notathip/PnET-CT23-Image-Processing-Auto-Alignment-Wireless-Charger/hardware/cad/README.md

# แบบจำลองสามมิติ

ภาพแบบประกอบอยู่ในโฟลเดอร์นี้ ไฟล์ Fusion ของแบบประกอบคือ `wireless_charger_assembly.f3d` เปิดใน Autodesk Fusion ด้วยคำสั่ง File > Open > Open from my computer
