notathip/PnET-CT23-Image-Processing-Auto-Alignment-Wireless-Charger/videos/README.md

# วิดีโอการทำงาน

- คลิปการทำงานของระบบ: https://youtube.com/shorts/St81rVh33vE
