notathip/PnET-CT23-Image-Processing-Auto-Alignment-Wireless-Charger/docs/block_diagram.png

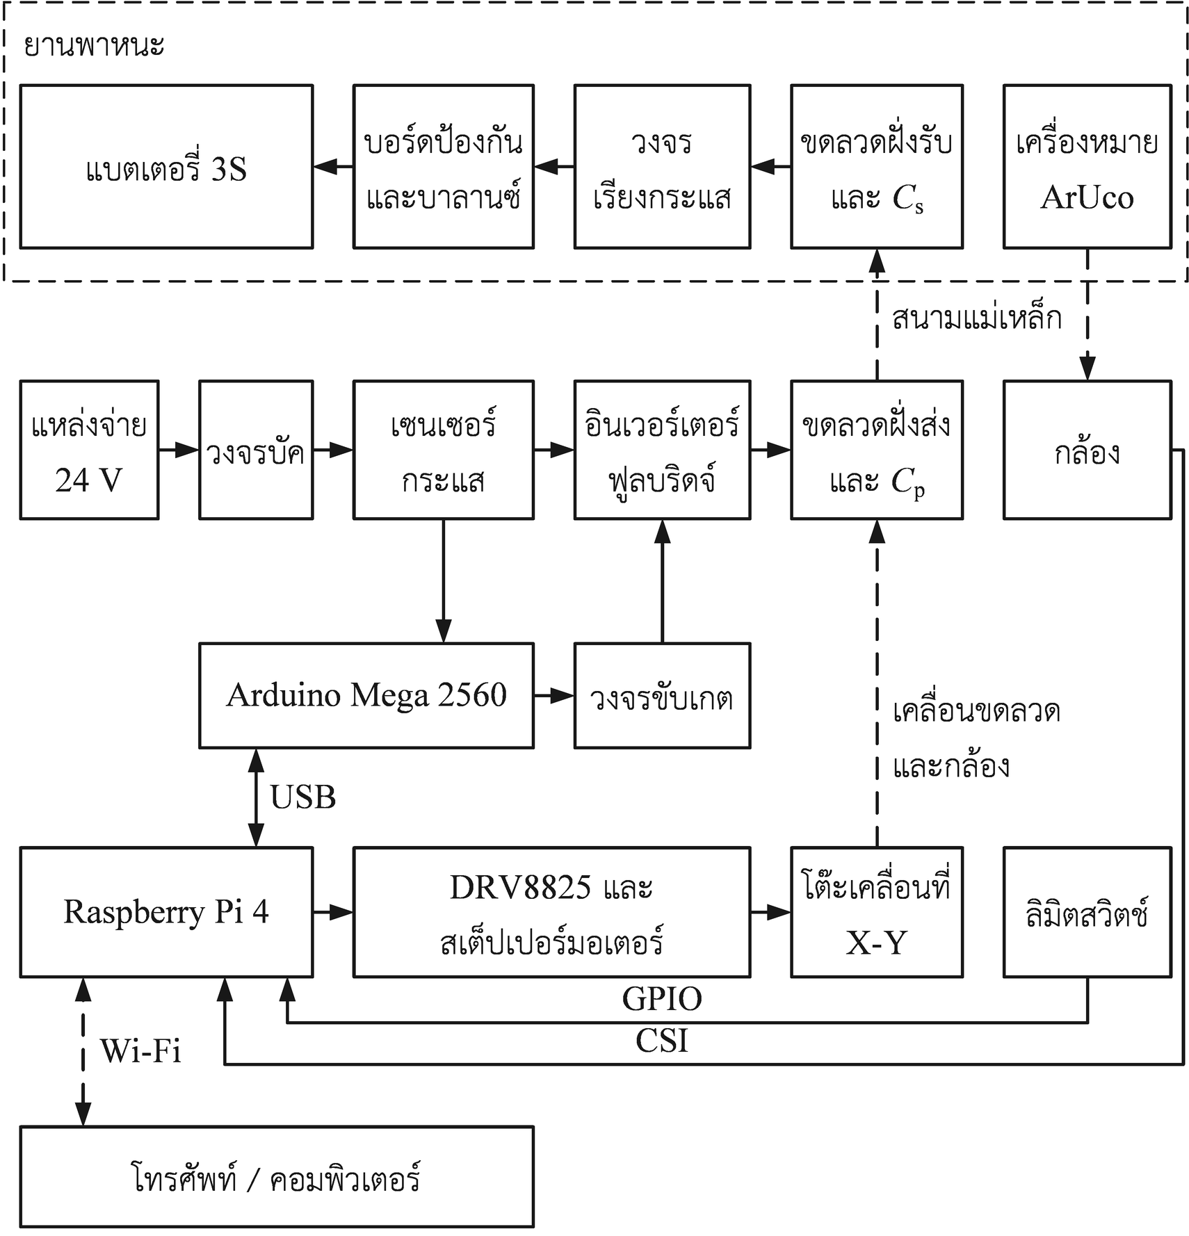
docs/block_diagram.png
