notathip/PnET-CT23-Image-Processing-Auto-Alignment-Wireless-Charger/docs/communication.png

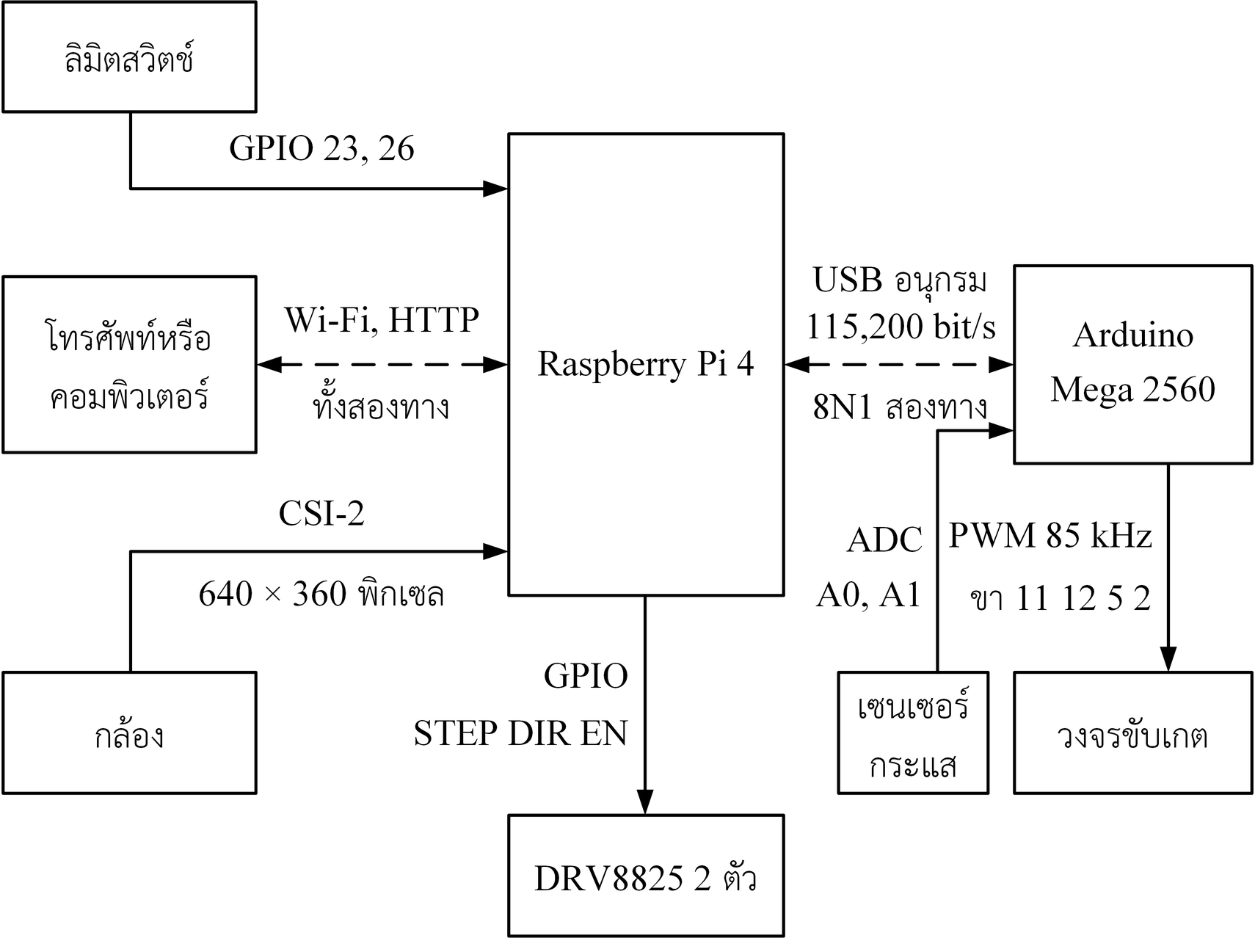
docs/communication.png
