notathip/PnET-CT23-Image-Processing-Auto-Alignment-Wireless-Charger/docs/sequence_power_stop.png

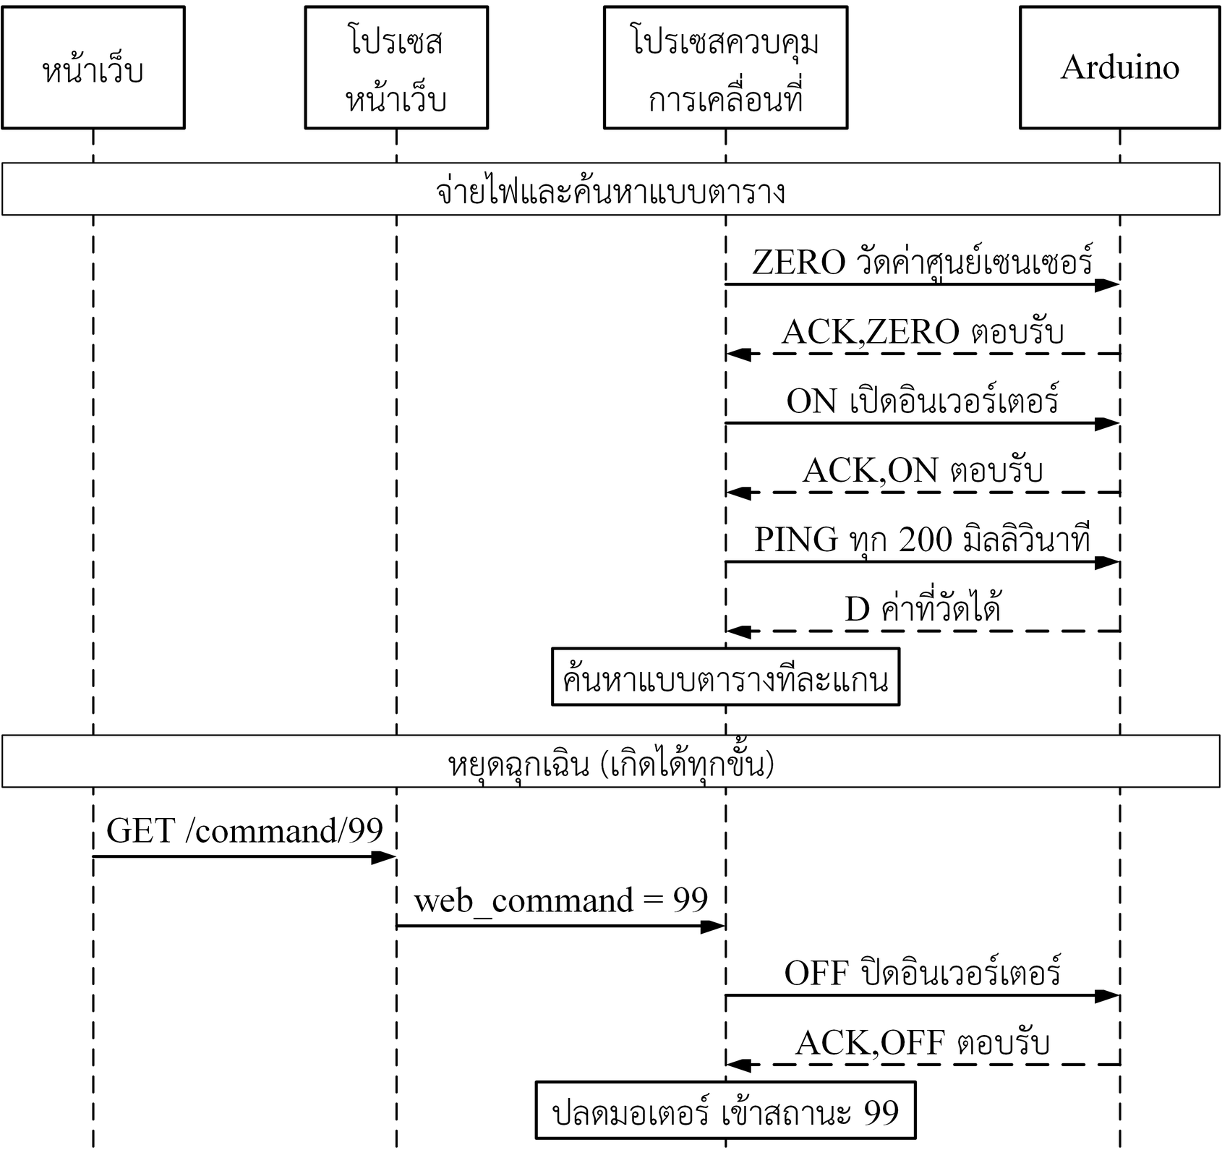
docs/sequence_power_stop.png
