notathip/PnET-CT23-Image-Processing-Auto-Alignment-Wireless-Charger/docs/sequence_search_aim.png

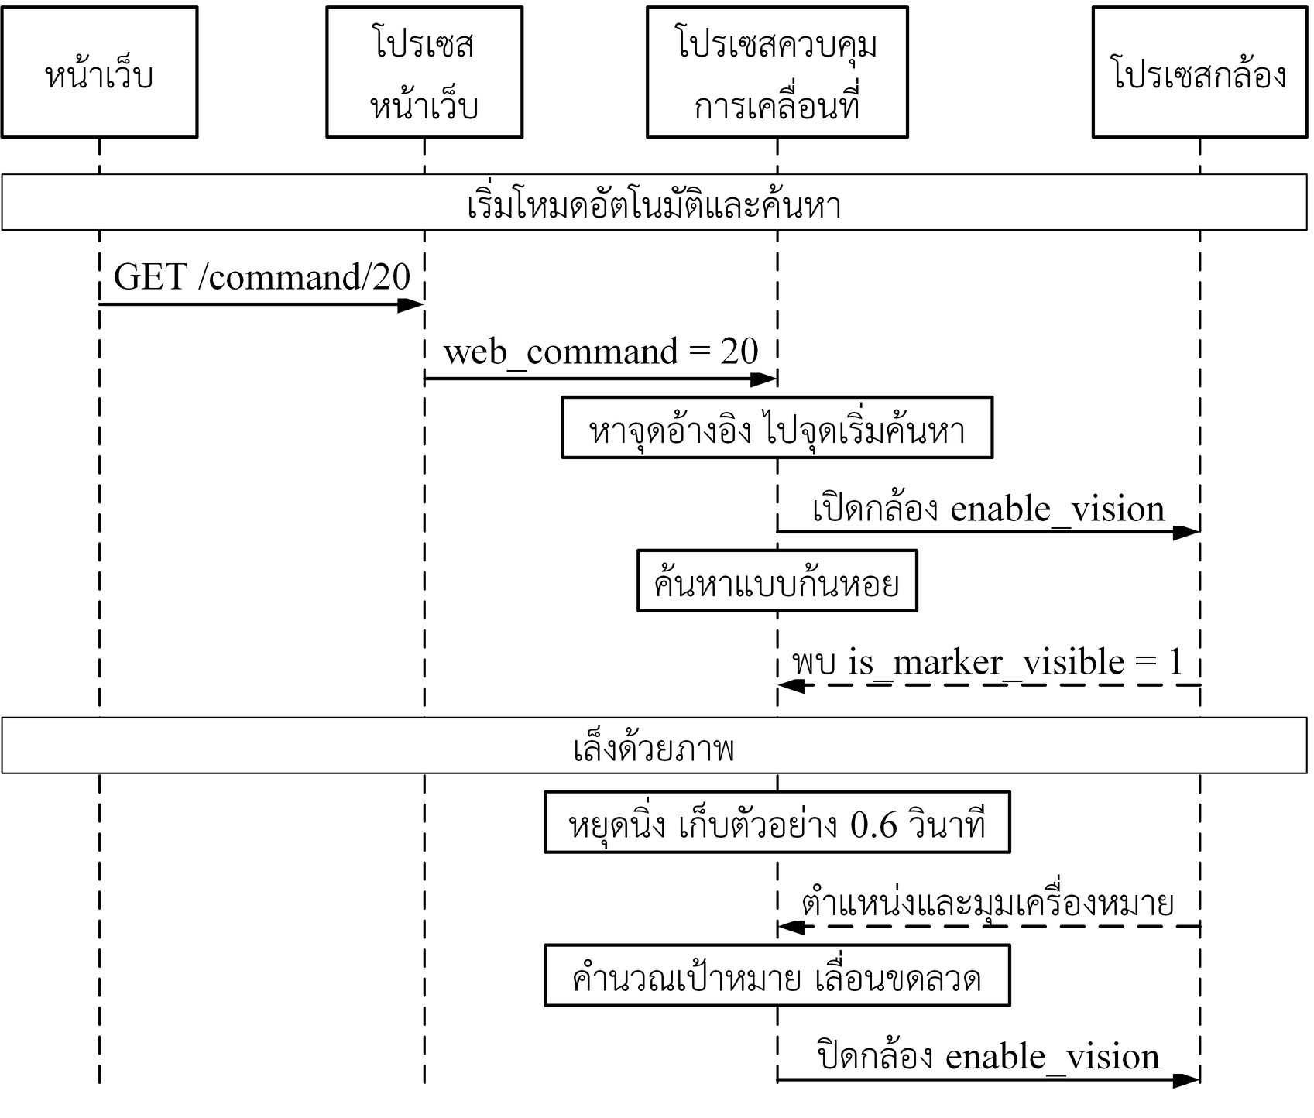
docs/sequence_search_aim.png
