notathip/PnET-CT23-Image-Processing-Auto-Alignment-Wireless-Charger/docs/state_diagram.png

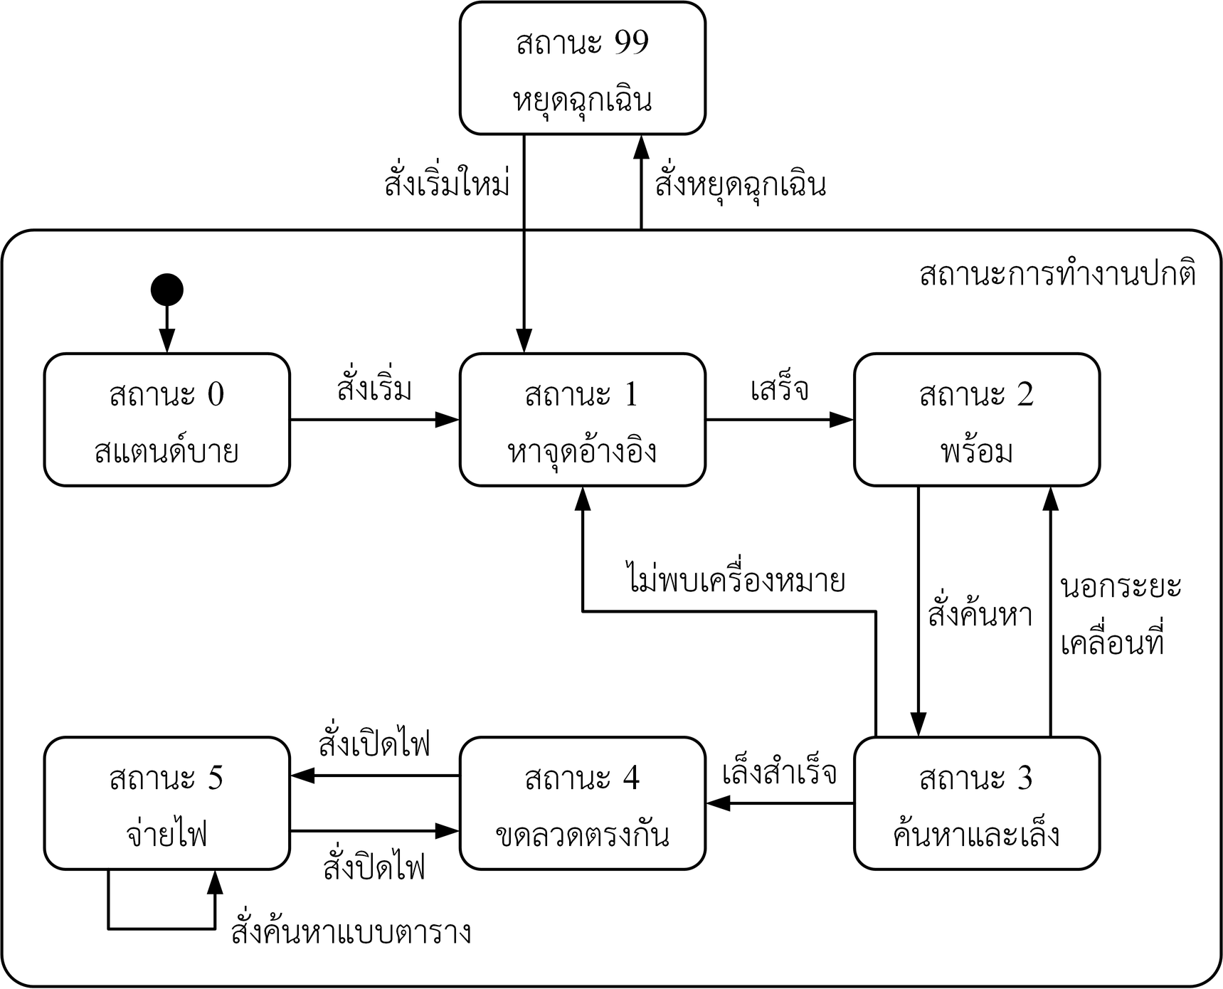
docs/state_diagram.png
