notathip/PnET-CT23-Image-Processing-Auto-Alignment-Wireless-Charger/hardware/cad/x_carriage_exploded.png

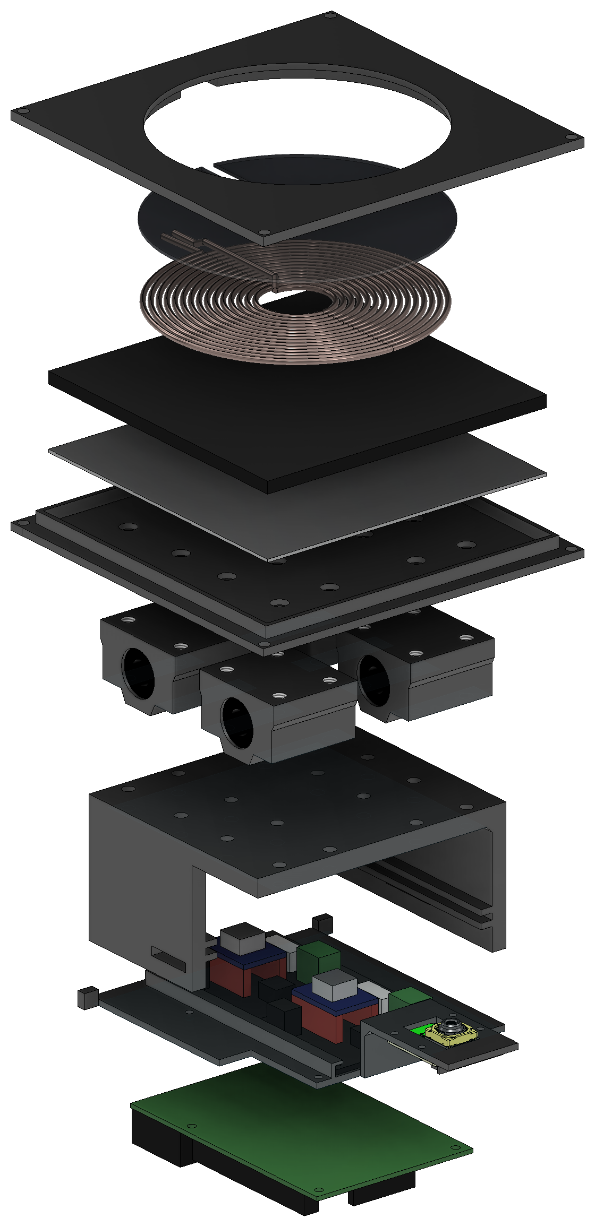
hardware/cad/x_carriage_exploded.png
