notathip/PnET-CT23-Image-Processing-Auto-Alignment-Wireless-Charger/(list of files, cad)

Other CAD files:
hardware/cad/wireless_charger_assembly.f3d
