notathip/PnET-CT23-Image-Processing-Auto-Alignment-Wireless-Charger/simulation/time_step_comparison.csv

ts_us | run_s | n | Vi | Ii | Ip_rms | Is_rms | Vo | Io | Pin | Pout | eta | ok
2 | 3.2 | 50001 | 10.0000 | 1.3795 | 1.4677 | 0.4499 | 3.9037 | 0.3904 | 13.795 | 1.524 | 11.047 | 1
1 | 1.2 | 100001 | 10.0000 | 2.4899 | 2.7540 | 1.0812 | 9.3792 | 0.9379 | 24.899 | 8.797 | 35.331 | 1
0.5 | 1.4 | 200001 | 10.0000 | 3.2624 | 3.6030 | 1.5639 | 13.2906 | 1.3291 | 32.624 | 17.664 | 54.145 | 1
0.2 | 2.7 | 500001 | 10.0000 | 3.5744 | 3.9621 | 1.7655 | 14.9906 | 1.4991 | 35.744 | 22.472 | 62.869 | 1
0.1 | 4.9 | 1000001 | 10.0000 | 3.6159 | 4.0148 | 1.8086 | 15.2569 | 1.5257 | 36.159 | 23.277 | 64.375 | 1
0.05 | 8.6 | 2000001 | 10.0000 | 3.6338 | 4.0355 | 1.8208 | 15.3582 | 1.5358 | 36.338 | 23.587 | 64.912 | 1
0.02 | 20.0 | 5000001 | 10.0000 | 3.6390 | 4.0418 | 1.8248 | 15.3901 | 1.5390 | 36.390 | 23.686 | 65.088 | 1
0.01 | 40.1 | 10000001 | 10.0000 | 3.6365 | 4.0409 | 1.8246 | 15.3875 | 1.5388 | 36.365 | 23.678 | 65.111 | 1
