notathip/PnET-CT23-Image-Processing-Auto-Alignment-Wireless-Charger/hardware/cad/assembly.png

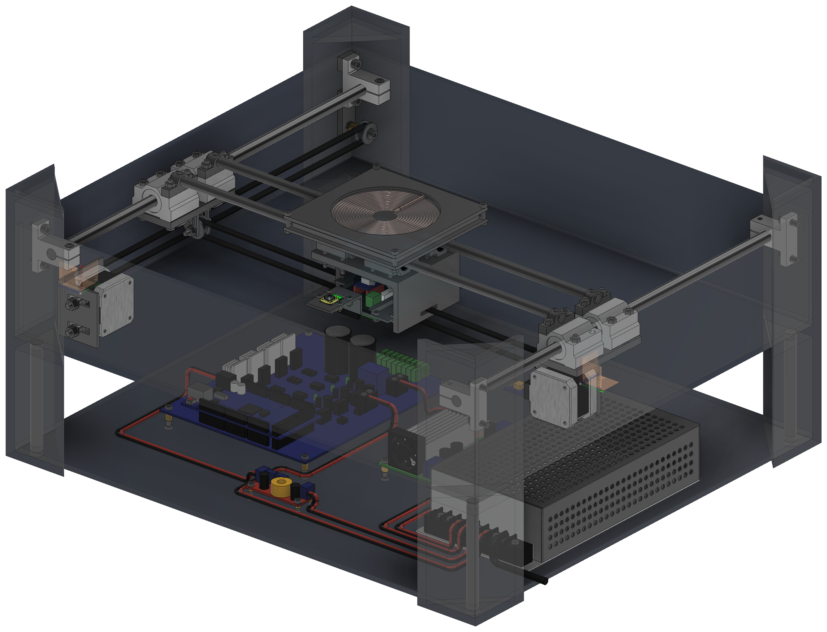
hardware/cad/assembly.png
