notathip/PnET-CT23-Image-Processing-Auto-Alignment-Wireless-Charger/hardware/pcb/PCB_Inverter_2.pdf

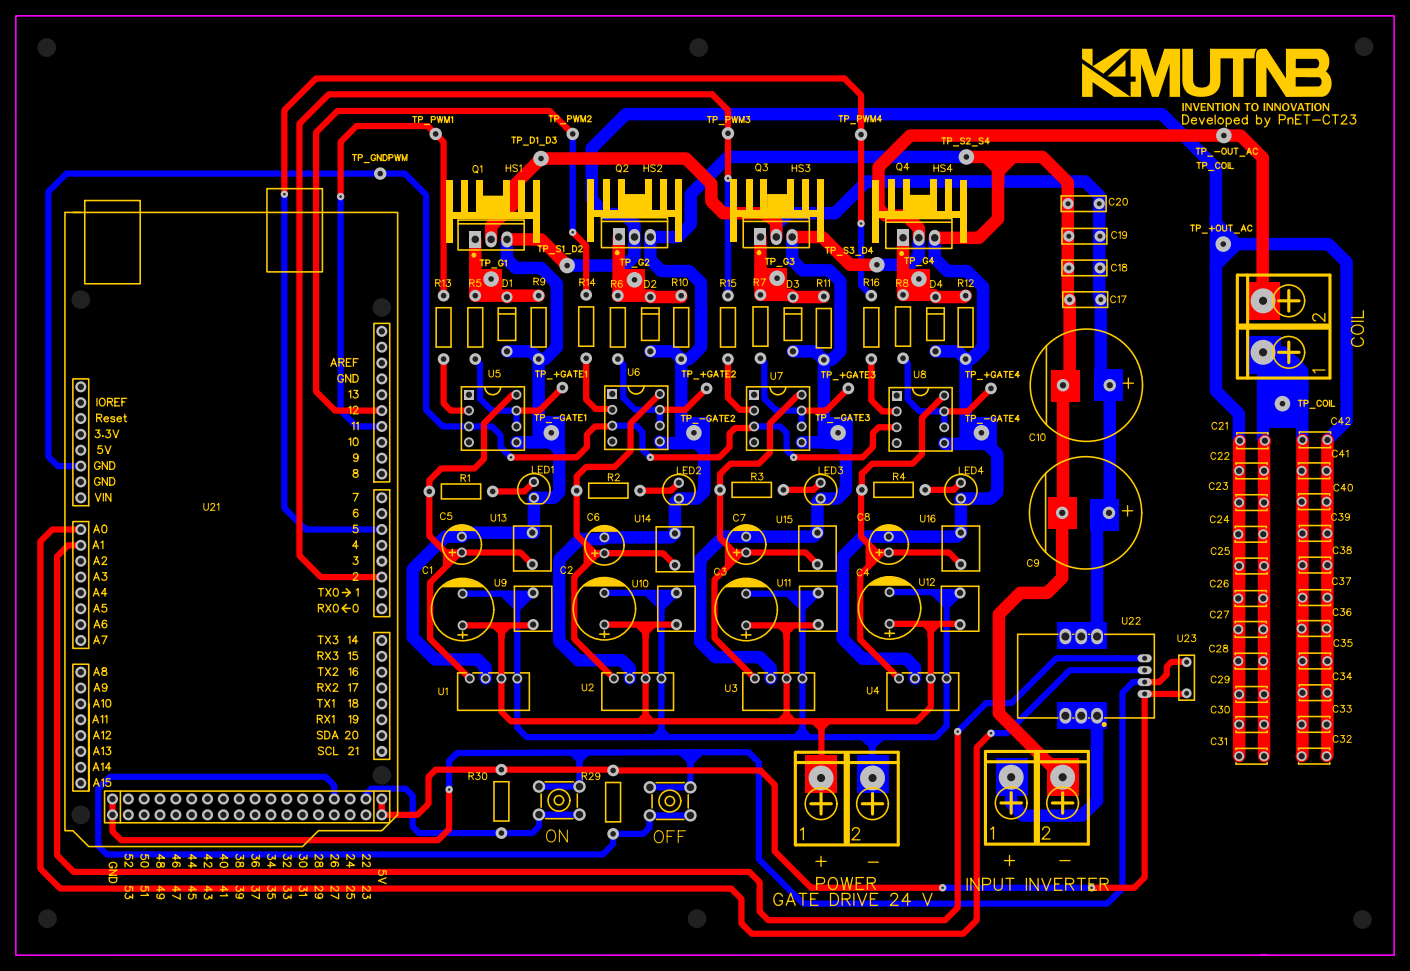
[picture p10: page 1]
