notathip/PnET-CT23-Image-Processing-Auto-Alignment-Wireless-Charger/hardware/pcb/PCB_Rectifier.pdf

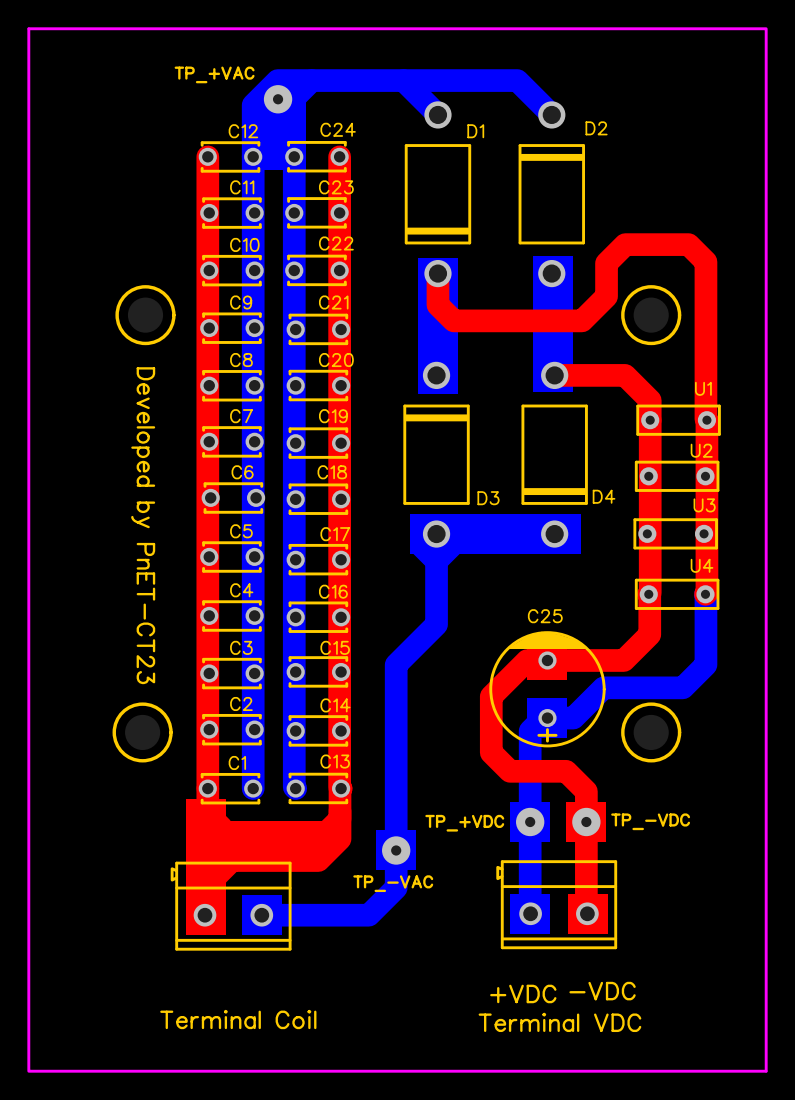
[picture p11: page 1]
