notathip/PnET-CT23-Image-Processing-Auto-Alignment-Wireless-Charger/hardware/pcb/Schematic_Inverter_2.pdf

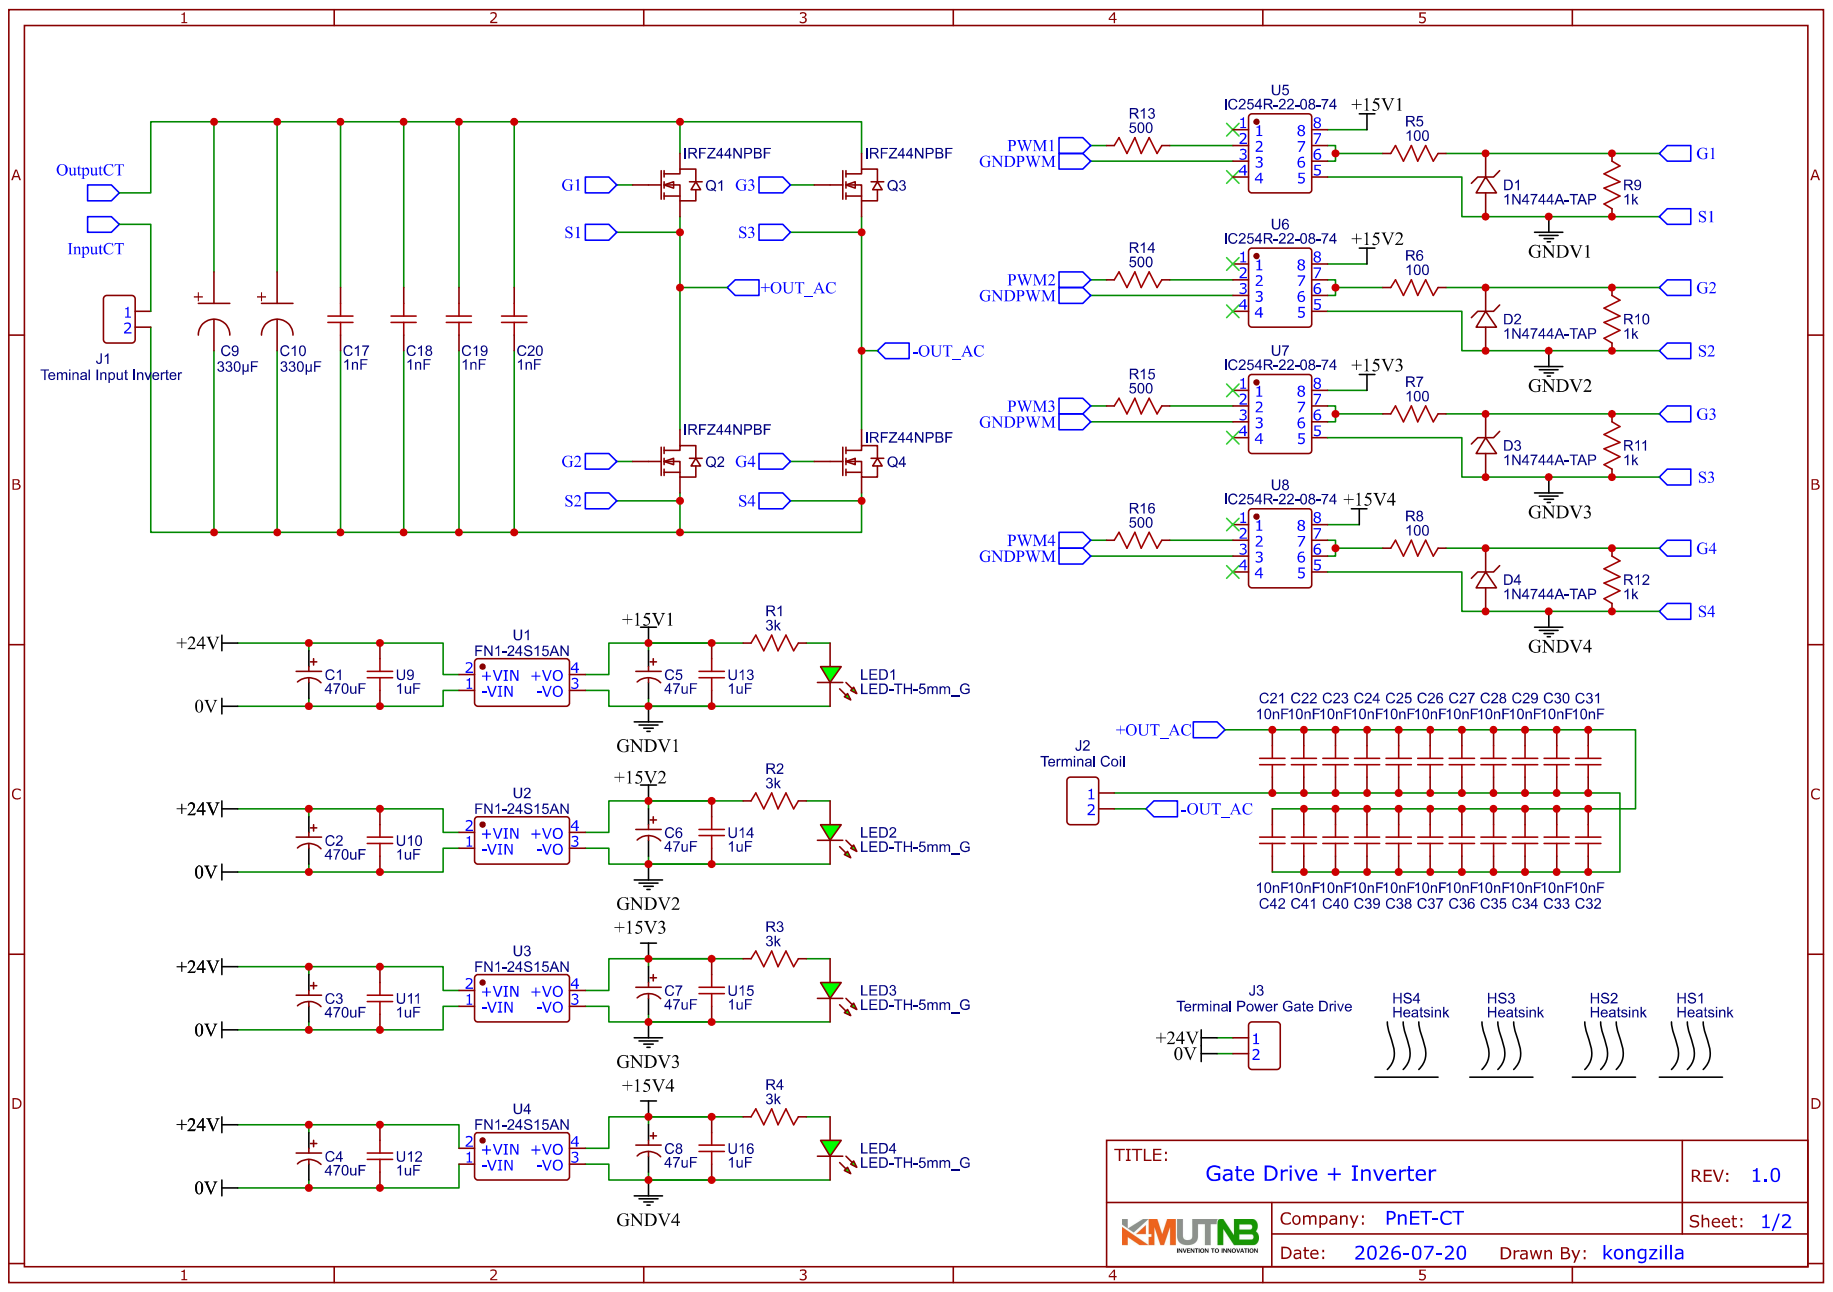
[picture p12: page 1]

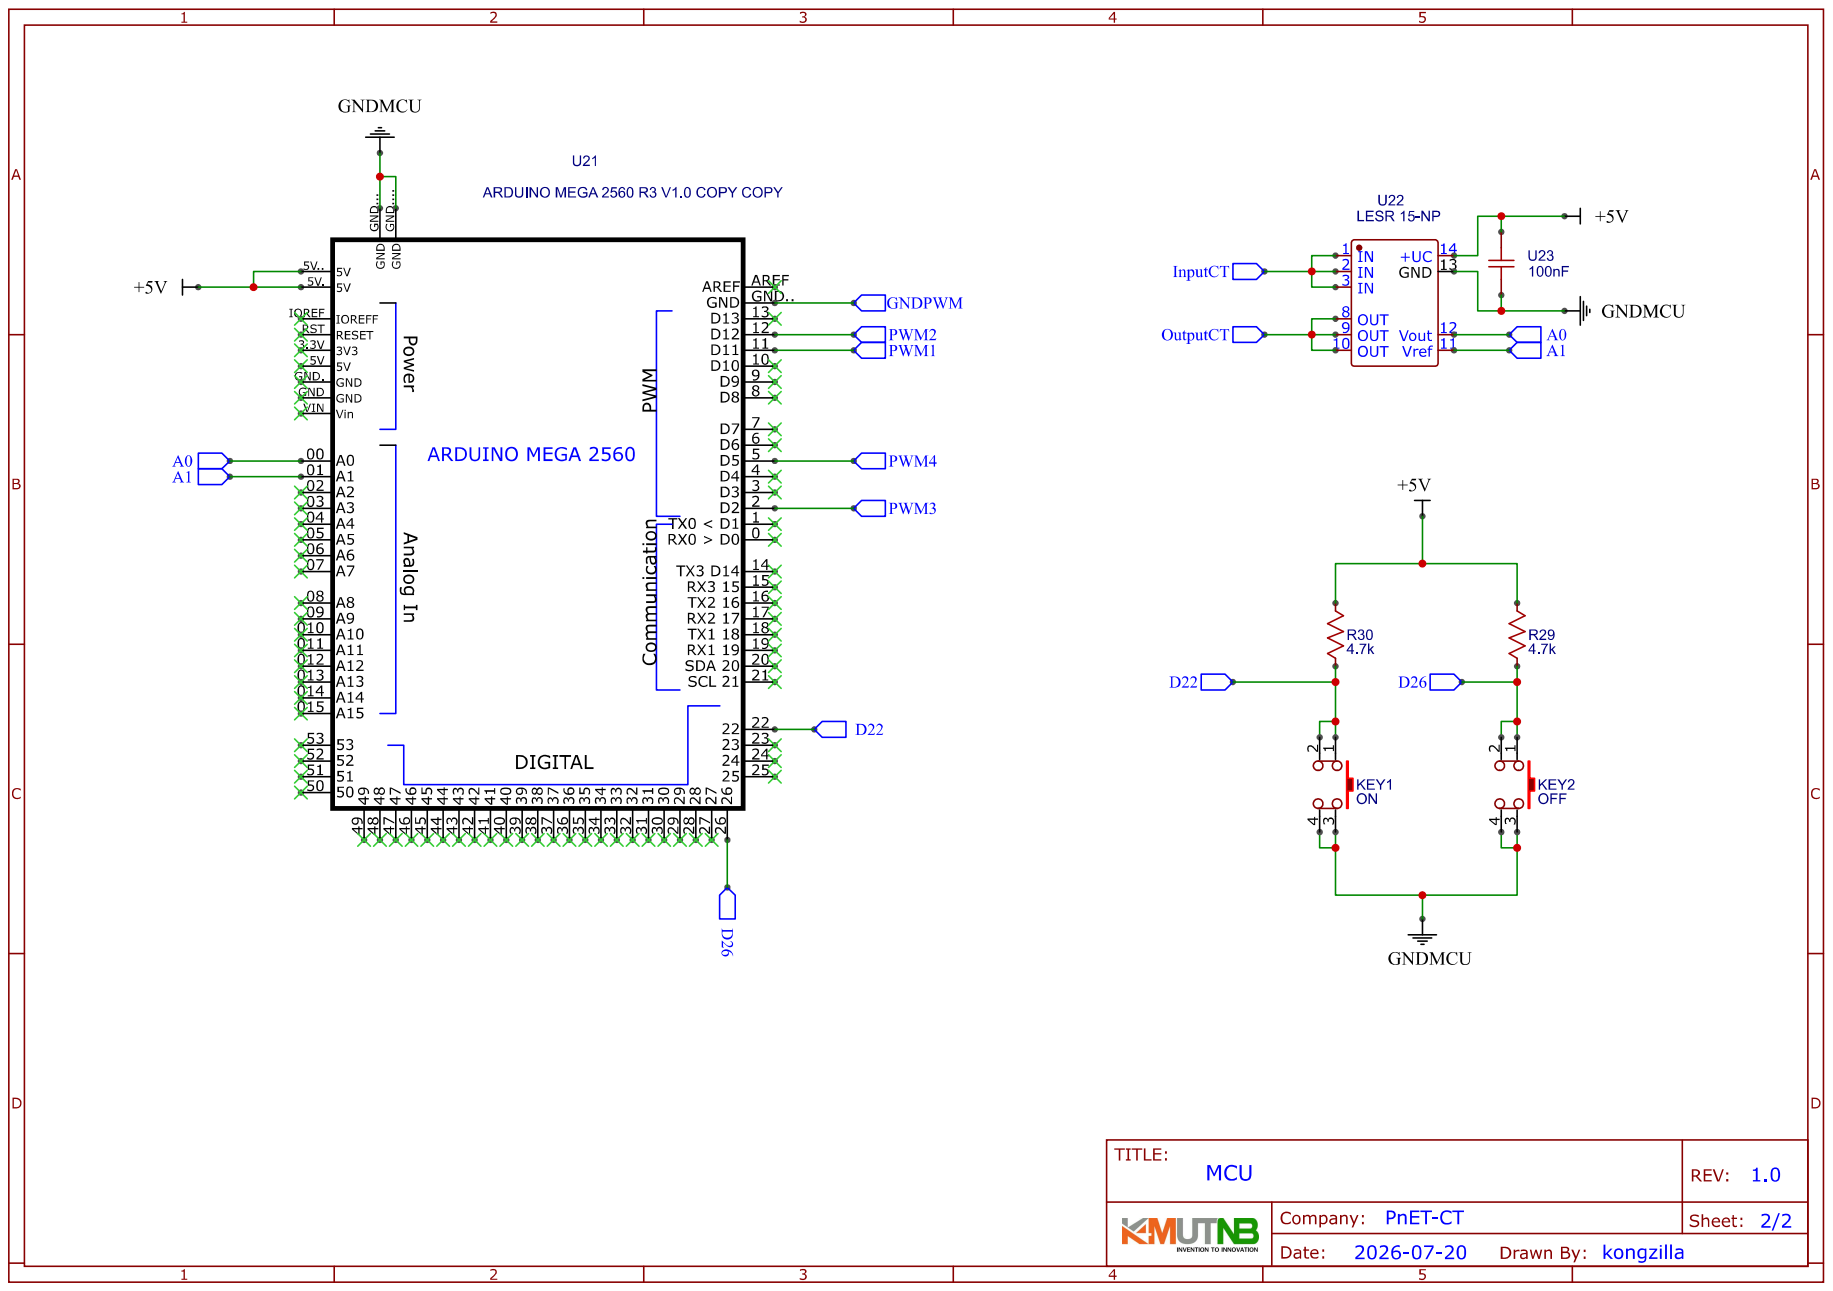
[picture p13: page 2]
