notathip/PnET-CT23-Image-Processing-Auto-Alignment-Wireless-Charger/hardware/pcb/Schematic_Rectifier.pdf

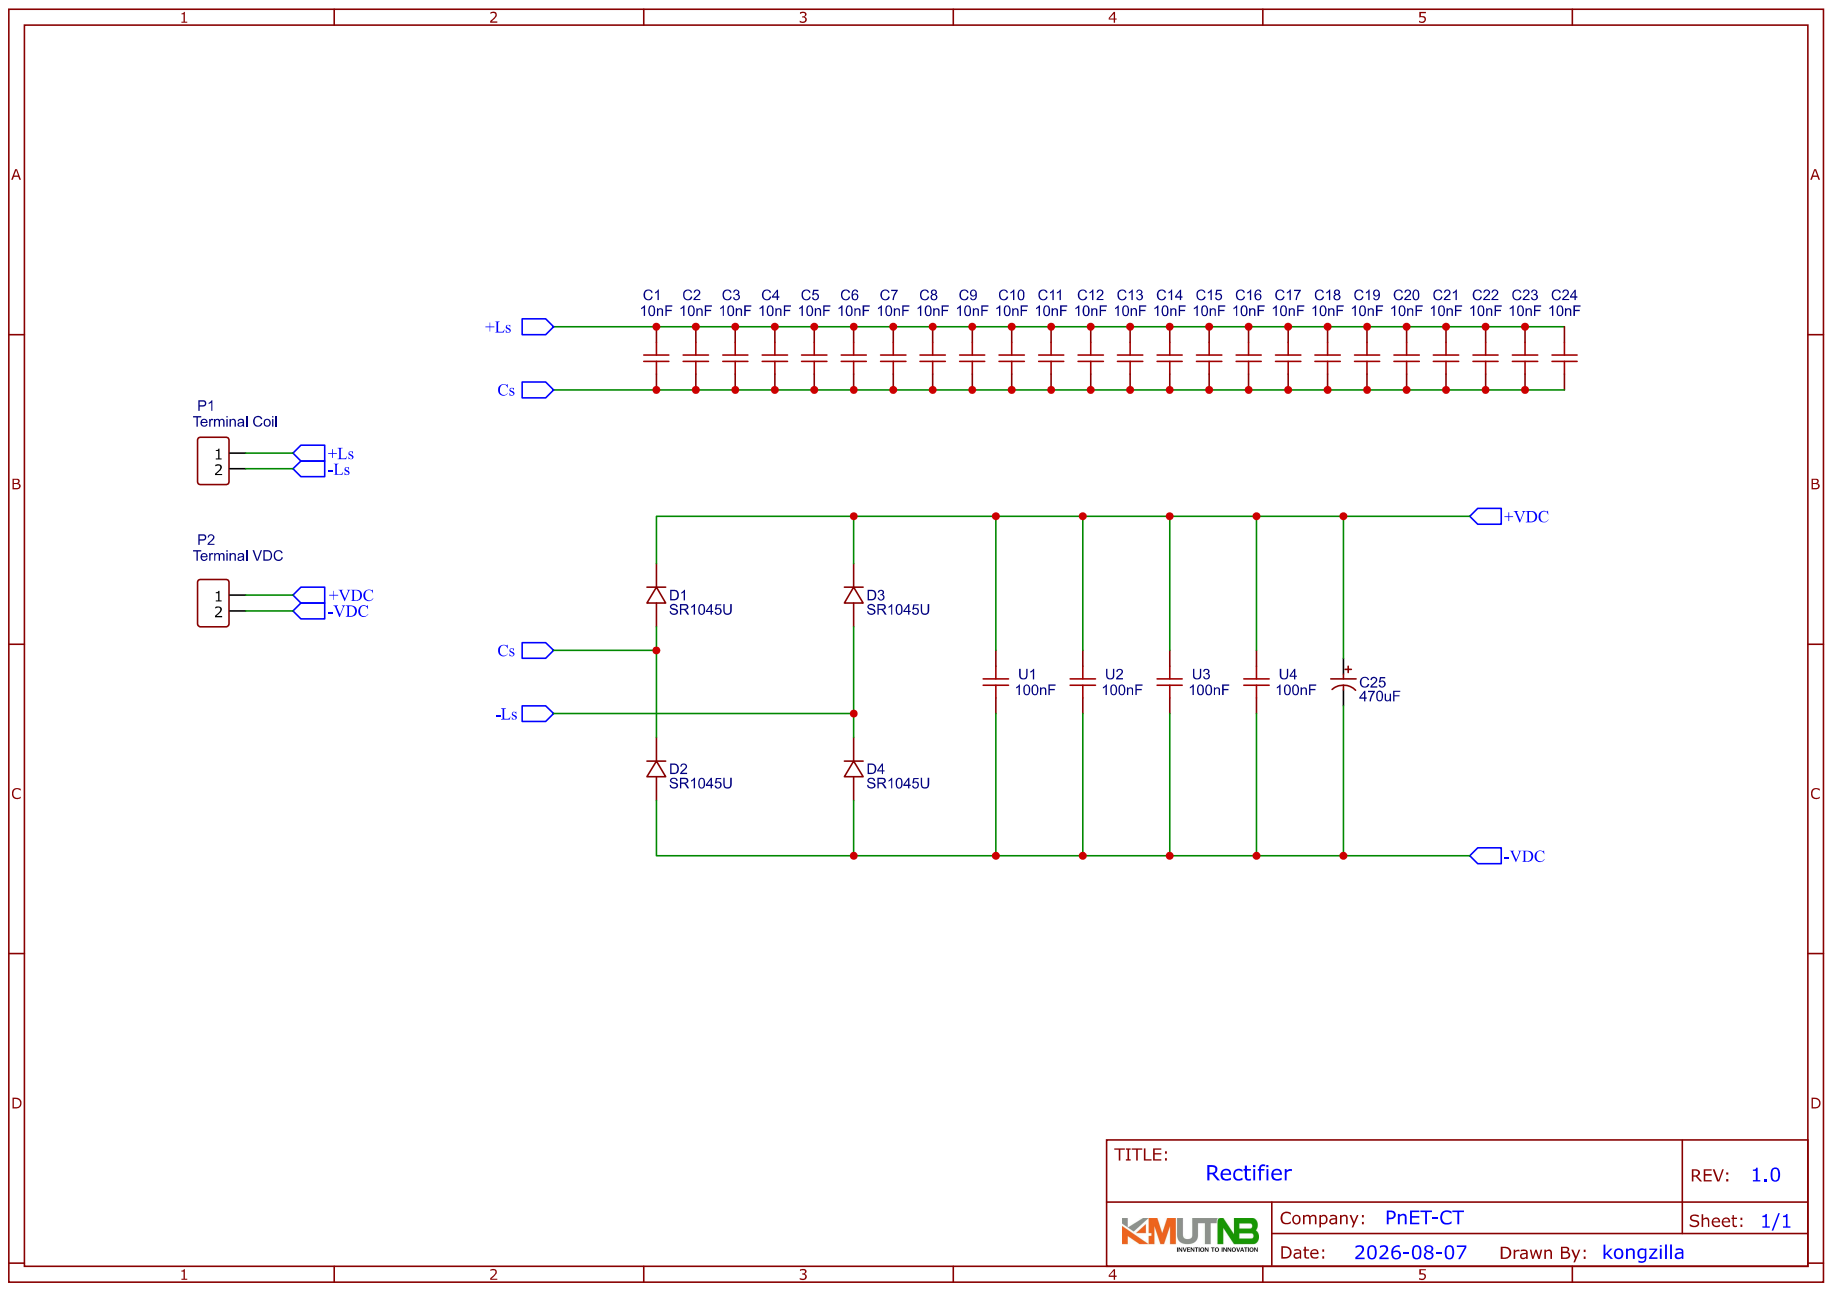
[picture p14: page 1]
